bdmg114/DigitalPN/docs/cost.md

# 생산 단가 추정

[hardware.md](hardware.md)의 부품표와 케이스 STL 부피로 계산한 **추정치**다. 견적을 받은 값이 아니다.
가격은 2026년 11월에 검색한 유통사 페이지(DigiKey, LCSC 등)의 캐시이며, 같은 부품도 페이지마다 값이 달라 중간값을 골랐다.
환율은 1 USD = 1,350원으로 잡았다(FRED 2026-10-30 기준 1,334원에 약간의 여유).

## 요약

| 시나리오 | 대당 원가 (USD) | 대당 원가 (원) | 일회성 비용 (별도) |
|---|---|---|---|
| 시제품 10대 (소량 구매, JLCPCB 조립, 케이스 직접 FDM 출력) | 약 85~95 | **약 11.5~13만** | — |
| 1,000대 (케이스 MJF 출력) | 약 45 | **약 6.1만** | 인증 |
| 10,000대 (케이스 사출) | 약 34 | **약 4.6만** | 인증 + 금형 (대당 원가에 금형 상각 포함) |

- 가장 큰 항목은 **디스플레이(Sharp LS027B7DH01A)** 다. 패널은 그대로 두고 중국 공급사에서 사는 [A안](#디스플레이-원가-절감안)을 채택해 1,000대 기준 $17.85 → $15.60으로 잡았다. 정식 유통(DigiKey) 가격이면 1,000대 원가는 약 $47(6.4만 원)이다.
- 1,000대 규모에서는 케이스(MJF 약 $9)가 두 번째로 크다. 사출 금형은 수천 대 이상에서야 MJF보다 싸진다.
- 인건비(직접 조립 시간), 설계비, 펌웨어 개발비, 유통 마진, 부가세는 넣지 않았다.

## 1,000대 기준 내역

| 항목 | 단가 근거 | 대당 (USD) |
|---|---|---|
| 디스플레이 LS027B7DH01A (A안: 중국 공급사) | Alibaba 1,000~4,999개 $15.60. 정식 유통은 DigiKey 400개 $17.85 | 15.60 |
| ESP32-S3-MINI-1-N8 | LCSC 650개 이상 $3.29~3.33 | 3.30 |
| 앞면 택트 스위치 39개 (Alps SKRP 계열) | LCSC SKRPABE010 1,000개 $0.041~0.045 | 1.76 |
| 어깨 스위치 2개 (측면 누름) | 추정 $0.10 | 0.20 |
| 다이오드 41개 (1N4148WS) | 추정 $0.005 | 0.20 |
| 배터리 503450 1000 mAh, 보호회로 | 대량 견적 공개가 없음. 유사 셀 1,000개 $1.9 + 인증·커넥터 여유 | 3.00 |
| 충전 BQ24074 | LCSC $0.47~0.99, Farnell $1.39 | 0.80 |
| 벅 TPS62840 | LCSC $0.55(BGA)~1.11(VSON) | 0.80 |
| 연료 게이지 MAX17048 | LCSC 1,000개 $0.60~0.67 | 0.65 |
| 디스플레이 5 V 승압 (필요 시) | 추정 | 0.30 |
| USB-C, FPC 커넥터, 크리스털, LED, ESD, 수동소자 | 추정 | 1.00 |
| PCB 138 × 66 × 1.0 mm | 추정 (2~4층) | 1.20 |
| PCB 조립 (양면, 약 470 접점) | JLCPCB 접점당 $0.0016~0.0017 + 셋업·확장 부품 수수료 상각 | 1.80 |
| **코어 소계** | | **30.6** |
| 앞판·뒷판·어깨 캡 MJF PA12 (26.4 cm³, 약 27 g) | JLC3DP $0.275/g (2025년 말 가격, 2026년 7월 추가 인하 공지 있음) | 7.30 |
| 키매트 좌우 TPU (5.9 cm³) | 추정 | 2.00 |
| M2 나사 6 + 열압입 인서트 6 | 추정 | 0.15 |
| 최종 조립·펌웨어 기록·검사 | 대당 10분 내외 가정 | 2.00 |
| 포장 | 추정 | 0.70 |
| 불량·운송 여유 5% | | 2.14 |
| **합계** | | **약 44.9 (약 6.1만 원)** |

STL 부피는 `hardware/case/stl/`의 파일에서 계산했다: 앞판 8.58, 뒷판 17.59, 키매트 2.92 + 2.96, 어깨 캡 0.13 × 2 cm³.
손잡이형은 앞판 9.15 + 뒷판 29.83 cm³라 MJF 비용이 약 $3.5 늘어난다.

## 10,000대 (사출) 가정

| 항목 | 대당 (USD) |
|---|---|
| 코어 (디스플레이 $14.30 = Alibaba 5,000개 이상 단가, 나머지 부품·조립 10~25% 인하 가정) | 27.0 |
| 사출 부품 (앞판·뒷판 PC/ABS, 실리콘 키매트, 어깨 캡) | 1.2 |
| 금형 상각 (앞판·뒷판·키매트·어깨 캡, 합계 약 $20,000 가정 ÷ 10,000대) | 2.0 |
| 나사·조립·검사·포장 | 2.1 |
| 불량·운송 여유 5% | 1.6 |
| **합계** | **약 33.9 (약 4.6만 원)** |

손바닥 크기 2부품 케이스의 단일 캐비티 P20 금형은 공급사 자료에서 $4,000~10,000 범위로 나온다. 1,000대에서 사출로 가면 금형만 대당 약 $20(2.7만 원)이 붙어 MJF보다 비싸다.

## 시제품 10대

| 항목 | 대당 (USD) |
|---|---|
| 디스플레이 (DigiKey 1개 단가. 시제품은 정품 기준을 잡기 위해 정식 유통에서 산다) | 27.6 |
| ESP32-S3 모듈 | 4.5 |
| 스위치 41개 (소량 단가 약 $0.10) | 4.1 |
| 배터리 (소매) | 8.0 |
| 전원 IC 4종 (소량 단가) | 7.6 |
| 다이오드·커넥터·수동소자 | 3.5 |
| PCB + 조립 (JLCPCB 10장, 양면 셋업·스텐실·확장 부품 수수료가 대부분) | 20.0 |
| 케이스 직접 FDM 출력 (PLA 약 32 g + TPU 약 7 g) + 나사 | 2.0 |
| **소계** | **약 77** |
| 배송·관세 10~20% | 8~15 |
| **합계** | **약 85~95 (약 11.5~13만 원)** |

케이스를 JLC3DP MJF로 맡기면 대당 약 $10이 더 든다.

## 일회성 비용

| 항목 | 메모 |
|---|---|
| 전파 인증 (KC 적합성평가, 수출 시 FCC/CE) | ESP32-S3-MINI-1 모듈은 자체 인증이 있지만 완제품 EMC 시험은 따로 필요하다. 금액은 시험소 견적으로 확인할 것 |
| 배터리 운송 인증 (UN38.3, IEC 62133) | 셀 공급사가 보유한 것을 쓰면 별도 비용이 거의 없다 |
| 사출 금형 | 10,000대 시나리오에 상각해 넣었다 |
| PCB 시제품 반복 | 위 시제품 비용 × 시제품 차수 |

## 판매가 감각

하드웨어 소매가는 보통 제조 원가의 2.5~4배로 잡는다(유통 마진, 반품, 지원, 개발비 회수). 1,000대 원가 6.1만 원이면 소매 15~24만 원, 10,000대 원가 4.6만 원이면 11.5~18만 원 수준이다.

## 디스플레이 원가 절감안

**결정 (2026-11): A안 채택.** 패널과 설계는 그대로 두고 구매처만 바꾼다. 아래 [A안 구매 조건](#a안-구매-조건)을 지킨다. B·C·D안은 A안 공급이 막히거나 수량이 늘어 다시 검토할 때를 위해 남겨 둔다.

정식 유통 가격 기준으로 디스플레이(Sharp LS027B7DH01A, 1,000대 기준 $18)는 원가의 약 40%다. 후보는 모두 반사형(백라이트 없음), SPI, 상시 표시가 되는 패널이다. 전자종이는 [hardware.md](hardware.md) 6절의 이유(부분 갱신 수백 ms)로 뺐다.

| 안 | 패널 | 해상도 / 표시 영역 | 16 px 글꼴 글자 수 | 단가 근거 | 1,000대 대당 원가 | 바뀌는 것 |
|---|---|---|---|---|---|---|
| 이전 | Sharp LS027B7DH01A 2.7", 정식 유통 | 240 × 400 / 35.3 × 58.8 mm | 15자 × 23줄 | DigiKey 400개 $17.85 | $47.4 (6.4만 원) | — |
| **A (채택)** | 같은 패널, 구매처만 바꿈 | 같음 | 같음 | Alibaba 중국 공급사 1,000~4,999개 $15.60 (공인 유통 아님) | $44.9 (6.1만 원) | 없음. 정품 여부·보증 위험 |
| B | Sharp LS018B7DH02 1.8" 메모리 LCD | 약 230 × 303 (자료마다 다름) | 14자 × 17줄 | DigiKey 960개 €11.4~12.7, 재고 없음(주문 생산) | 약 $42 (5.7만 원) | 케이스 창 크기. 구동 방식은 같은 Sharp 프로토콜이라 펌웨어는 해상도만 바꿈 |
| **C** | **ST7305 반사형 TFT 2.9"** (Good Display GDTL029T51, Midas MDTR0290A-SPI) | 168 × 384 / 30.5 × 68.3 mm | 10자 × 22줄 | Good Display 1개 $6.89, Midas 100개 $9.97 | **약 $35 (4.8만 원)** | **본체 세로 약 +14 mm**, PCB·케이스 다시 그림, 디스플레이 드라이버 새로 작성 |
| D | ST7305 반사형 TFT 2.13" (Midas MDTR0213A-SPI 등) | 122 × 250 / 26.5 × 51.6 mm | 7자 × 14줄 (12 px 글꼴이면 10자 × 19줄) | Midas 500개 $6.08 | 약 $32 (4.4만 원) | 케이스 창 크기, 드라이버 새로 작성 |

계산 방법: 정식 유통 기준 1,000대 내역($47.4)에서 디스플레이 단가만 바꾸고 불량·운송 여유 5%를 다시 곱했다. C와 D는 1,000개 단가를 공개 자료에서 찾지 못해 소량 단가에서 추정했다(C $5.5, D $4). ST7305는 3.3 V로 동작해 5 V 승압 회로($0.3)가 빠진다. C는 케이스가 커져 MJF 비용이 약 $1.3 늘어나는 것까지 넣었다.

### 판단

- **D는 권하지 않는다.** 가장 싸지만 한 줄에 7자가 들어간다. 8단계 들여쓰기를 하면 본문 폭이 3자로 줄어 항목 트리 화면이 성립하지 않는다.
- **C가 절감 폭이 가장 크다(대당 약 1.6만 원, 25%).** 대가는 세 가지다.
  1. 표시 영역이 68 mm로 지금 화면 자리(64 mm)보다 길다. 모듈 외곽은 데이터시트로 확인해야 하지만 본체가 70 → 약 84 mm로 커질 것으로 본다. 가로로 쥐는 기기의 세로가 스마트폰 폭(약 72 mm)보다 커져 바지 주머니 수납이 나빠지고, 키 묶음 위치도 [타자 시뮬레이션](simulation.md)으로 다시 확인해야 한다.
  2. 글자 수가 15자에서 10자로 준다. 화소가 0.17 mm로 지금(0.147 mm)보다 커서 같은 16 px 글자가 실제로는 15% 크게 보인다.
  3. 화소가 상태를 기억하는 메모리 LCD가 아니다. 저주파 모드(0.25~8 Hz)로 상시 표시 전력을 줄이는 방식이다. 같은 계열 ST7301의 자료로는 저전력 모드 약 25 µA, 일반 주사 약 300 µA이며, ST7305의 실제 값은 데이터시트로 확인해야 한다. 이 값이면 하루 소모가 1 mAh 안쪽으로 늘어 배터리 수명에는 거의 영향이 없다.
- **B는 크기를 지키면서 대당 약 7천 원(11%)을 줄인다.** 케이스 바깥 치수와 PCB 외곽은 그대로 두고 창과 디스플레이 자리만 바꾸면 된다. 다만 재고 없이 주문 생산이라 리드타임 확인이 먼저다.
- **A는 설계를 바꾸지 않지만 절감이 작고(약 3천 원) 비공인 유통 위험이 있다.** 수천 대 규모가 되면 Sharp 공인 대리점에 직접 견적을 받는 쪽이 낫다.

### A안 구매 조건

A안의 위험은 설계가 아니라 공급이다. 정식 유통이 아닌 곳의 패널은 재생품, 장기 재고, 비슷한 다른 패널이 섞여 있을 수 있다(판매 페이지에서 2.7"와 2.8"를 섞어 쓰는 곳도 있었다). 다음을 지킨다.

1. **시제품(0~2단계)은 정식 유통(DigiKey·Mouser)에서 산다.** 정품 기준 샘플을 확보해 두고, 나중에 들어오는 패널을 이것과 비교한다.
2. **공급사 2곳 이상에서 샘플 5~10개를 먼저 받는다.** 결제는 거래 보증(Alibaba Trade Assurance 같은 에스크로)으로 한다.
3. **입고 검사**: 부품 번호 각인과 제조 날짜 코드 확인, FPC·외곽 치수를 정품 샘플과 비교, 실제 구동(전체 흑백 패턴, 줄 단위 갱신, 1 Hz 극성 반전으로 24시간 잔상 확인), 소비 전류를 정품 샘플과 비교.
4. **양산 주문은 나눠서 넣는다.** 첫 주문은 100~200개로 하고, 검사 불량률이 2%를 넘으면 그 공급사는 쓰지 않는다.
5. **정식 유통 가격을 대안으로 유지한다.** 단가 차이는 대당 $2.25(약 3천 원)라 A안이 막혀도 원가가 크게 흔들리지 않는다. 수천 대 규모가 되면 Sharp 정식 대리점에 직접 견적을 받아 A안 단가와 비교한다.
6. **보증 조건**: 공급사가 불량 패널 교환을 해 주는지 계약 전에 받아 둔다. 30개월 약정 판매를 하면 A/S 기간이 길어 교체용 재고도 확보해야 한다.

## 원가를 줄이는 방향

1. **디스플레이**: 원가의 약 35~40%. A안(구매처 변경)을 채택했다. 더 줄이려면 B·C안. 위 [디스플레이 원가 절감안](#디스플레이-원가-절감안) 참조.
2. **전원 IC 통합**: 충전·벅·게이지 3칩($2.25)을 PMIC 하나로 묶거나, 게이지를 빼고 ADC 전압 추정으로 바꾸면 $0.6~1 줄어든다(정확도는 떨어진다).
3. **단면 조립**: 스위치는 앞면, 나머지는 뒷면이라 양면 조립이다. 뒷면 부품을 줄이거나 스위치만 수삽/리플로 한 번으로 묶으면 조립비가 준다.
4. **케이스**: 1,000대까지는 MJF, 수천 대 이상부터 사출. 손잡이형은 부피가 커서 MJF 단가가 오른다.

## 이 추정의 한계

- 가격은 검색 결과의 캐시 페이지에서 가져왔고 페이지마다 값이 달랐다. 발주 전에 실시간 견적으로 다시 확인해야 한다.
- 배터리, PCB, 수동소자, 사출 부품 단가는 공개 단가를 찾지 못해 가정한 값이다.
- 회로도가 아직 없어 부품 수(특히 수동소자와 디스플레이 승압 회로 필요 여부)가 확정되지 않았다.
- 디스플레이 리드타임이 28주로 표시된 유통사도 있어, 수량보다 공급 일정이 먼저 문제가 될 수 있다.

## 출처

- Sharp LS027B7DH01A — [DigiKey](https://azcus.digikey.com/en/products/detail/sharp-microelectronics/LS027B7DH01A/5054067), [Findchips](https://www.findchips.com/search/LS027)
- ESP32-S3-MINI-1-N8 — [LCSC C2913206](https://www.lcsc.com/product-detail/C2913206.html?s_z=t_HCTL)
- Alps SKRPABE010 — [LCSC C115360](https://www.lcsc.com/product-detail/C115360.html), [TME](https://www.tme.com/ca/en/details/skrpabe010/microswitches-tact/alps/)
- BQ24074 — [LCSC C54313](https://www.lcsc.com/product-detail/C54313.html), [Farnell](https://il.farnell.com/texas-instruments/bq24074rgtr/batt-charger-li-ion-1-5a-vqfn/dp/3008700RL)
- TPS62840 — [LCSC C2071139](https://www.lcsc.com/product-detail/C2071139.html)
- MAX17048 — [LCSC C2682616](https://www.lcsc.com/product-detail/C2682616.html?s_z=n_gd32)
- 503450 배터리 — [Alibaba 유사 셀](https://www.alibaba.com/product-introduction/High-Capacity-Li-Ion-Polymer-Battery_1600910076009.html), [Ormix](https://ormix.lv/en/product/11420)
- JLCPCB 조립비 — [가격 안내](https://jlcpcb.com/help/article/pcb-assembly-price), [FAQ](https://jlcpcb.com/help/article/98-pcb-assembly-faqs)
- JLC3DP MJF — [가격 인하 공지](https://jlc3dp.com/blog/drastic-material-price-cuts-and-adjusted-post-processing-service-fees), [2026년 7월 공지](https://jlc3dp.com/news/materials-finishing-pricing-update-july2026)
- 사출 금형 — [DEV Community](https://dev.to/china-sourcing-agents/injection-mold-tooling-costs-for-electronics-enclosures-16dl), [Haizol](https://www.haizol.com/blog/low-volume-injection-molding)
- 디스플레이 대체안 — [Alibaba LS027B7DH01A](https://www.alibaba.co.uk/product-detail/LS027B7DH01A-Original-2-7-Inch-LCD_1601529829368.html), [DigiKey LS018B7DH02](https://www.digikey.ie/en/products/detail/sharp-microelectronics/LS018B7DH02/25953409), [Good Display GDTL029T51](https://buyepaper.com/products/gdtl029t51), [DigiKey MDTR0290A-SPI](https://www.digikey.com.mx/en/products/detail/midas-displays/MDTR0290A-SPI/25588717), [DigiKey MDTR0213A-SPI](https://www.digikey.com.mx/en/products/detail/midas-displays/MDTR0213A-SPI/25588716), [ST7305 데이터시트](https://files.waveshare.com/wiki/common/ST_7305_V0_2.pdf), [Zephyr ST7305 바인딩](https://docs.zephyrproject.org/latest/build/dts/api/bindings/display/sitronix,st7305.html), [ST7301 저전력 수치](https://www.orientdisplay.com/wp-content/uploads/2022/08/ST7301.pdf)
- 환율 — [FRED DEXKOUS](https://fred.stlouisfed.org/graph?g=7sEa)
