bdmg114/DigitalPN/hardware/case/stl/dpn-gripA-bottom.stl

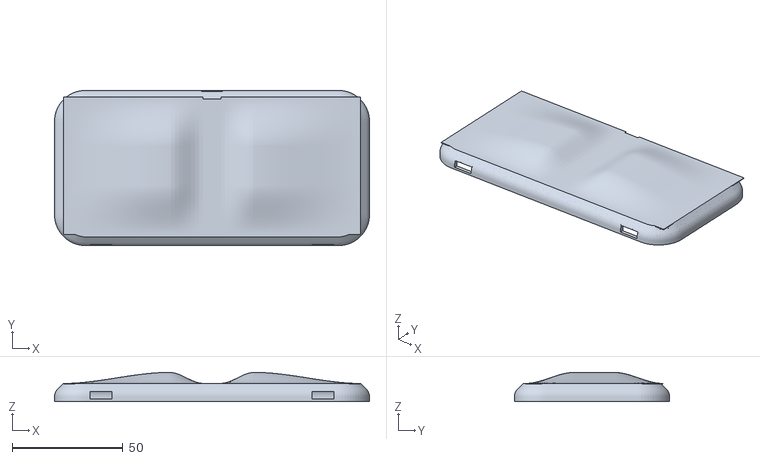
[picture p11: CAD file, 2026-11-12]
hardware/case/stl/dpn-gripA-bottom.stl
142.0 x 70.0 x 13.2
