bdmg114/DigitalPN/hardware/case/stl/dpn-gripB-bottom.stl

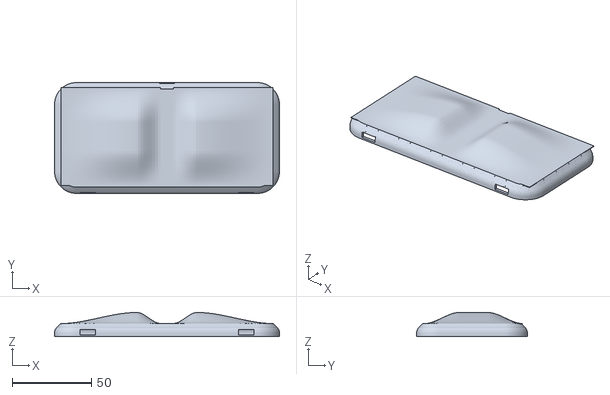
[picture p12: CAD file, 2026-11-12]
hardware/case/stl/dpn-gripB-bottom.stl
142.0 x 70.0 x 15.2
