bdmg114/DigitalPN/hardware/case/stl/dpn-gripC-bottom.stl

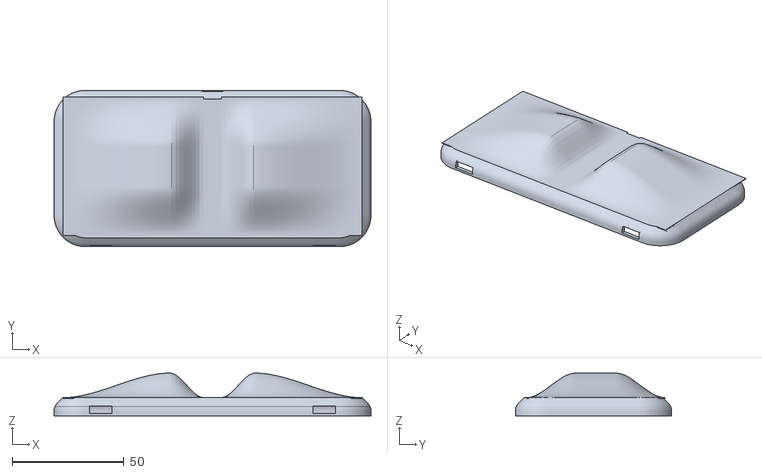
[picture p13: CAD file, 2026-11-12]
hardware/case/stl/dpn-gripC-bottom.stl
142.0 x 70.0 x 19.2
