bdmg114/DigitalPN/hardware/case/stl/dpn-bottom.stl

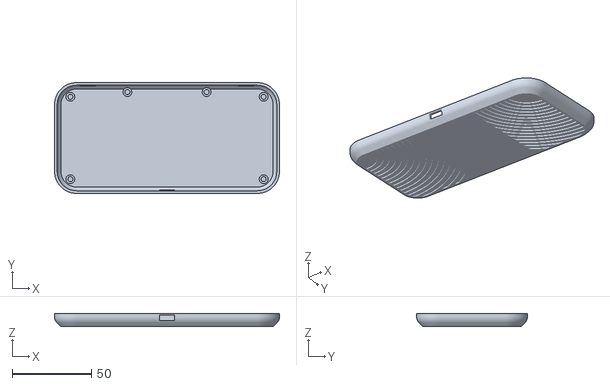
[picture p14: CAD file, 2026-11-12]
hardware/case/stl/dpn-bottom.stl
142.0 x 70.0 x 8.20
