bdmg114/DigitalPN/hardware/case/stl/dpn-grip-top.stl

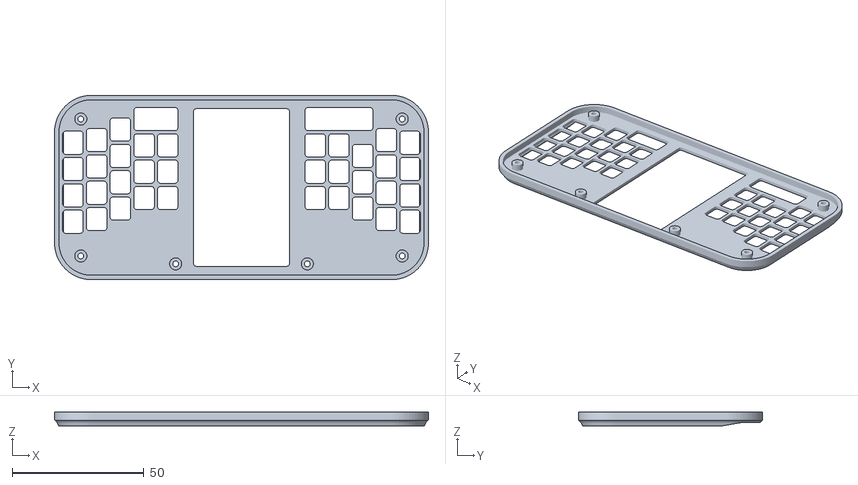
[picture p15: CAD file, 2026-11-12]
hardware/case/stl/dpn-grip-top.stl
142.0 x 70.0 x 5.50
