bdmg114/DigitalPN/hardware/case/stl/dpn-top.stl

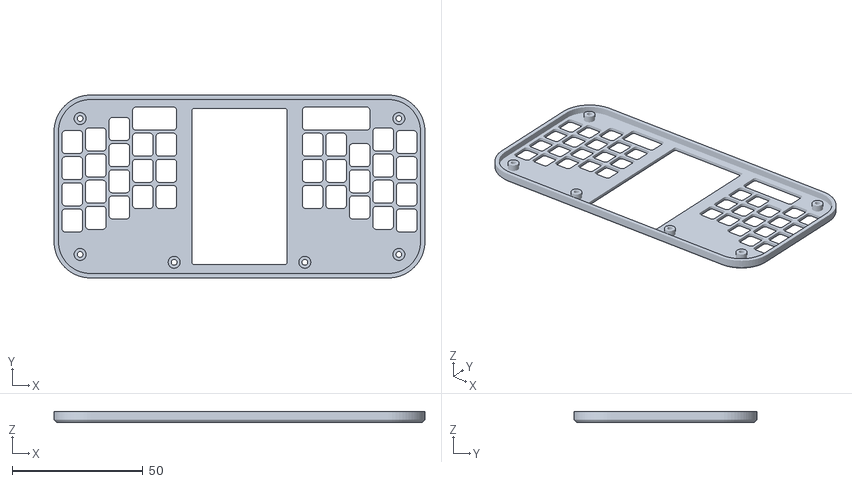
[picture p16: CAD file, 2026-11-12]
hardware/case/stl/dpn-top.stl
142.0 x 70.0 x 4.10
