bdmg114/DigitalPN/hardware/case/stl/dpn-keymat_r.stl

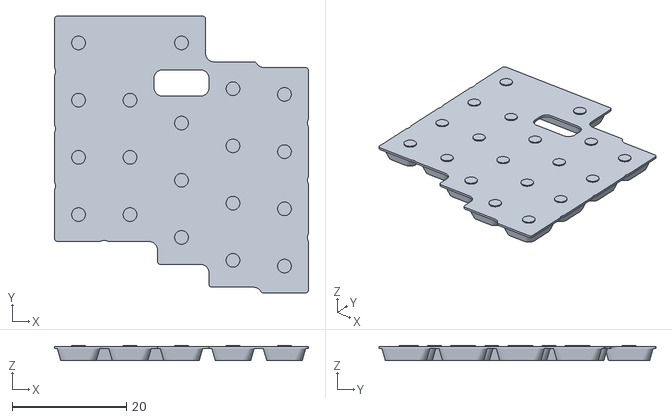
[picture p17: CAD file, 2026-11-12]
hardware/case/stl/dpn-keymat_r.stl
44.4 x 48.4 x 2.69
