bdmg114/DigitalPN/hardware/case/stl/dpn-shoulder.stl

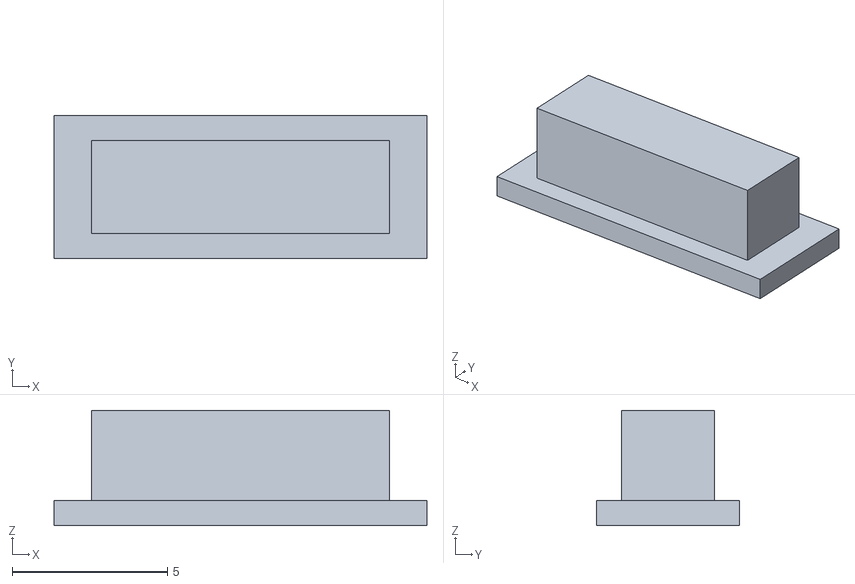
[picture p18: CAD file, 2026-11-12]
hardware/case/stl/dpn-shoulder.stl
12.0 x 4.60 x 3.70
