bdmg114/DigitalPN/(list of files, cad)

Other CAD files:
hardware/case/stl/dpn-keymat_l.stl
hardware/case/stl/dpn-bottom-sls.stl
