bdmg114/DigitalPN/(commit log)

2026-11-11 Add handheld digital typewriter design: hardware, input, firmware, data format, case
    - Design docs for a landscape two-thumb device with a centre display and split 5x4 key clusters
    - Item record JSON Schema (JSONL journal) with a validated sample
    - Sync protocol spec shared by BLE, HTTPS and USB
    - Parametric OpenSCAD reference case built from a core interface file
    - Dubeolsik Hangul automaton in portable C with host tests
    Claude-Session: https://claude.ai/code/session_01Qbd6HCyQTD29JtFwbSJU1b
    [case.scad, dpn_core.scad]
2026-11-11 Add thumb-kinematics typing simulator (work in progress)
    Joint-range thumb model, grip optimisation, two-thumb timing and error model,
    design-space sweep and figure scripts. Results and design updates follow.
    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
2026-11-11 Simulate thumb typing with joint limits and update design to v0.2
    - Thumb kinematic model (CMC/MCP/IP ranges), grip optimisation, two-thumb
    timing and error model, design sweep, sensitivity analysis, figures
    - Findings in docs/simulation.md
    - Core interface v0.2: row pitch 10.0 mm, key clusters moved 10 mm down
    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
    [case.scad, dpn_core.scad]
2026-11-11 Curve key rows to the thumb reach band (v0.3) and add 3D typing videos
    - Optimise per-column vertical offsets with the thumb model (sim/curve.py):
    +2.4% effective speed and -19% mean joint strain versus the flat grid
    - Core interface v0.3: col_dy offsets, top-centre screws, keymat follows curve
    - 3D animation of the simulated grip, joint postures and press timing
    - Fix Enter keystrokes being skipped in the timing model; rerun sweep,
    sensitivity and figures with updated numbers
    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
    [case.scad, dpn_core.scad]
2026-11-11 Reshape case for grip and pocket carry with support-free curved edges
    - R14 plan corners, boat-hull back edge (45-degree limited for FDM), flat back
    - Recessed concentric grip grooves, lower keycaps, flush shoulder buttons
    - Optional full-radius edge for SLS/resin
    - Core interface v0.4: PCB corner R12, corner screws moved inward
    - Print orientation and settings in docs/case.md
    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
    [case.scad, dpn_core.scad]
2026-11-12 Export print-ready STLs for the case parts
    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
    [case.scad, dpn-bottom-sls.stl, dpn-bottom.stl, dpn-keymat_l.stl, dpn-keymat_r.stl, dpn-shoulder.stl, dpn-top.stl]
2026-11-12 Add grip-style case variant, TAB key, and parent-child item tree
    - Case: style="grip" adds rear palm swells with finger ledges and a front
    rim for one-handed holding; slim style unchanged
    - Core interface v0.5: left space bar 2u plus TAB key
    - Item schema v2: parent links replace note grouping; indent/outdent rewrite
    a single record
    - Input, firmware and data docs updated; key lock state documented
    - Regenerated STLs
    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
    [case.scad, dpn-bottom.stl, dpn-grip-bottom.stl, dpn-grip-top.stl, dpn-keymat_l.stl, dpn-keymat_r.stl, dpn-top.stl, dpn_core.scad]
2026-11-12 Add production cost estimate for prototype, 1k and 10k runs
    Claude-Session: https://claude.ai/code/session_01Qbd6HFSyTMbtJGDPrgGKZT
2026-11-12 Adopt display option A: same Sharp panel from a China supplier
    Recompute the 1k and 10k cost totals with the new display price and add
    sourcing safeguards (genuine reference samples, incoming inspection,
    split orders, authorized-distributor fallback).
    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
2026-11-12 Grip simulation and organically blended grip swells (work in progress)
    - sim/grip.py: one-hand hold statics (contact forces with friction, LP)
    across device orientations, hand sizes and friction levels
    - Case grip style now uses a tangent-blended heightfield swell with
    simulation-selected A/B/C candidates
    - Final sweep results, figures and docs follow
    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
    [case.scad, dpn-grip-bottom.stl, dpn-gripA-bottom.stl, dpn-gripB-bottom.stl, dpn-gripC-bottom.stl]
2026-11-12 Select grip candidates by simulation and blend swells into the body
    - Grip swells moved under the fingertips (crest 52 mm inboard) per sim;
    three height candidates A/B/C, B default
    - Swell is a tangent-continuous heightfield with long fade-out
    - Grip simulation results, figure and caveats documented in docs/case.md
    - Grip bottom prints open-side down so the hand surface stays clean
    - STLs regenerated
    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
    [dpn-gripA-bottom.stl, dpn-gripB-bottom.stl, dpn-gripC-bottom.stl]
2026-11-12 Add grip simulation videos
    3D animation of the one-hand hold statics: contact force arrows for the slim
    case and grip candidate B while the device orientation sweeps, with live
    force and relative-load bars for all four cases.
    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
